mayurbhandary/TongueControl/REVB.brd

## EAGLE design REVB.brd (2019-01-13)

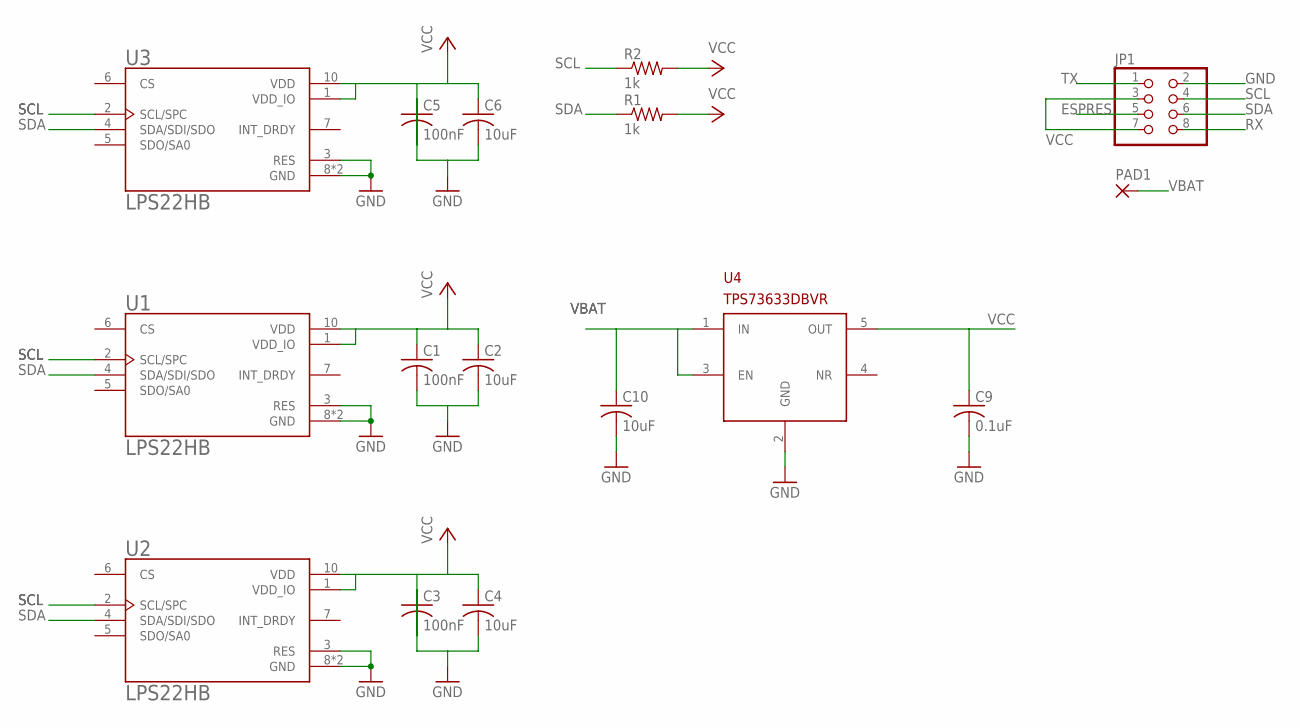
[picture p17: schematic REVB.sch]

Parts:
C1, C3, C5: 100nF; C0402
C2, C4, C6, C10: 10uF; C0402
C9: 0.1uF; C0402
JP1: PINHD-2X4/90; 2X04/90
PAD1: 2,15/1,0
R1, R2: 1k; R0402
U1, U2, U3: LPS22HB; LGA10R50P2X3_200X200X80
U4: TPS73633DBVR; SOT23-DBV

Connections:
GND: C1.2, C2.2, C3.1, C4.2, C5.1, C6.2, C9.2, C10.2, JP1.2, U1.3 (RES), U1.8 (GND), U1.9 (GND), U2.3 (RES), U2.8 (GND), U2.9 (GND), U3.3 (RES), U3.8 (GND), U3.9 (GND), U4.2 (GND); also elsewhere on the board
SCL: JP1.4, R2.1, U1.2 (SCL/SPC), U2.2 (SCL/SPC), U3.2 (SCL/SPC); also elsewhere on the board
SDA: JP1.6, R1.1, U1.4 (SDA/SDI/SDO), U2.4 (SDA/SDI/SDO), U3.4 (SDA/SDI/SDO); also elsewhere on the board
VBAT: C10.1, PAD1.1, U4.1 (IN), U4.3 (EN)
VCC: C1.1, C2.1, C3.2, C4.1, C5.2, C6.1, C9.1, JP1.3, JP1.7, R1.2, R2.2, U1.1 (VDD_IO), U1.10 (VDD), U2.1 (VDD_IO), U2.10 (VDD), U3.1 (VDD_IO), U3.10 (VDD), U4.5 (OUT); also elsewhere on the board

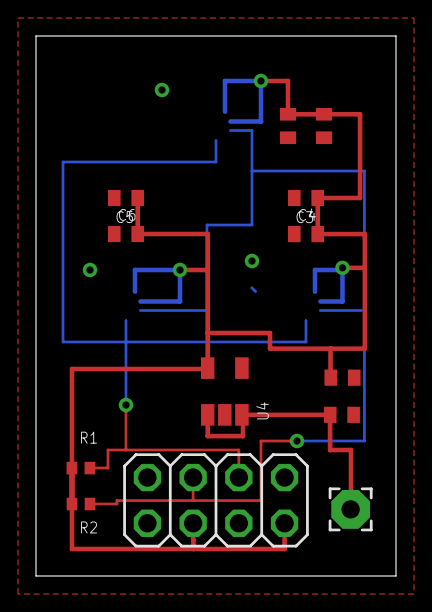
[picture p18: board REVB.brd from above]

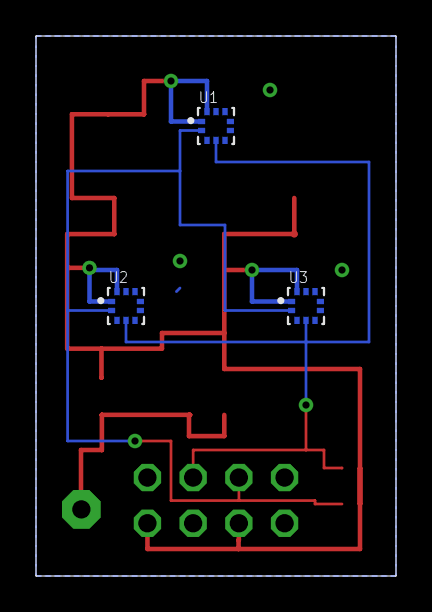
[picture p19: board REVB.brd from below]

Board: 2 copper layers, 20.0 x 30.0 mm, 16 parts (3 on the bottom side), 5 nets.

Other parts of the board:
JP2: 2X04

Their connections:
GND: JP2.7; also elsewhere on the board
SCL: JP2.5; also elsewhere on the board
SDA: JP2.3; also elsewhere on the board
VCC: JP2.2, JP2.6; also elsewhere on the board
